audric/arduino-humidity-eco-ventilation/(commit log)

2015-03-31 aggiunto schema
    [lcd_keypad_df_robot.xls]
2015-04-01 added relay actions
2015-04-22 ragionamenti sui collegamenti
    [lcd_keypad_df_robot.xls]
2015-10-09 translations
    corrected here & there a few translation errors
    [VentilazioneArchivioLCD.ino]
2017-02-20 Added error message for missing sensors
    [VentilazioneArchivioLCD.ino]
2017-02-20 Added error message for missing sensor
    [VentilazioneArchivioLCD.ino]
